sperly/wasdat/wasdat/wasdat.step

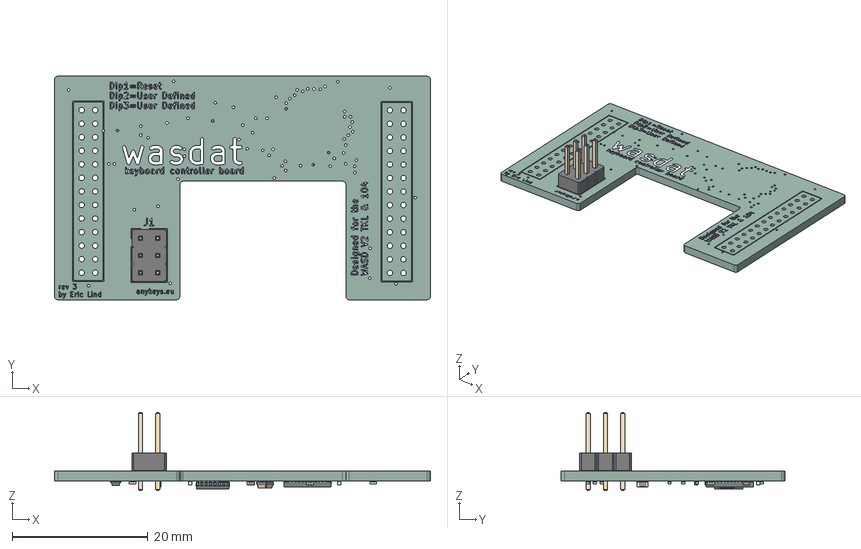
[picture p1: CAD file, 2026-08-13]
wasdat/wasdat.step
55.5 x 33.0 x 11.5 mm
PinHeader_2x03_P254mm_Vertical
C_0402_1005Metric x 7
R_0402_1005Metric x 9
C_0603_1608Metric
TSSOP-16_4.4x5mm_P0.65mm
QFN-44-1EP_7x7mm_Pitch0.5mm
Crystal_SMD_2016-4Pin_2.0x1.6mm
SOT_666
wasdat-unsaved-export-wxZfDO_silkscreen x 2
wasdat-unsaved-export-wxZfDO_PCB
