sperly/wasdat/wasdat/wasdat.kicad_pcb

## KiCad design wasdat/wasdat.kicad_pcb (2026-08-13)

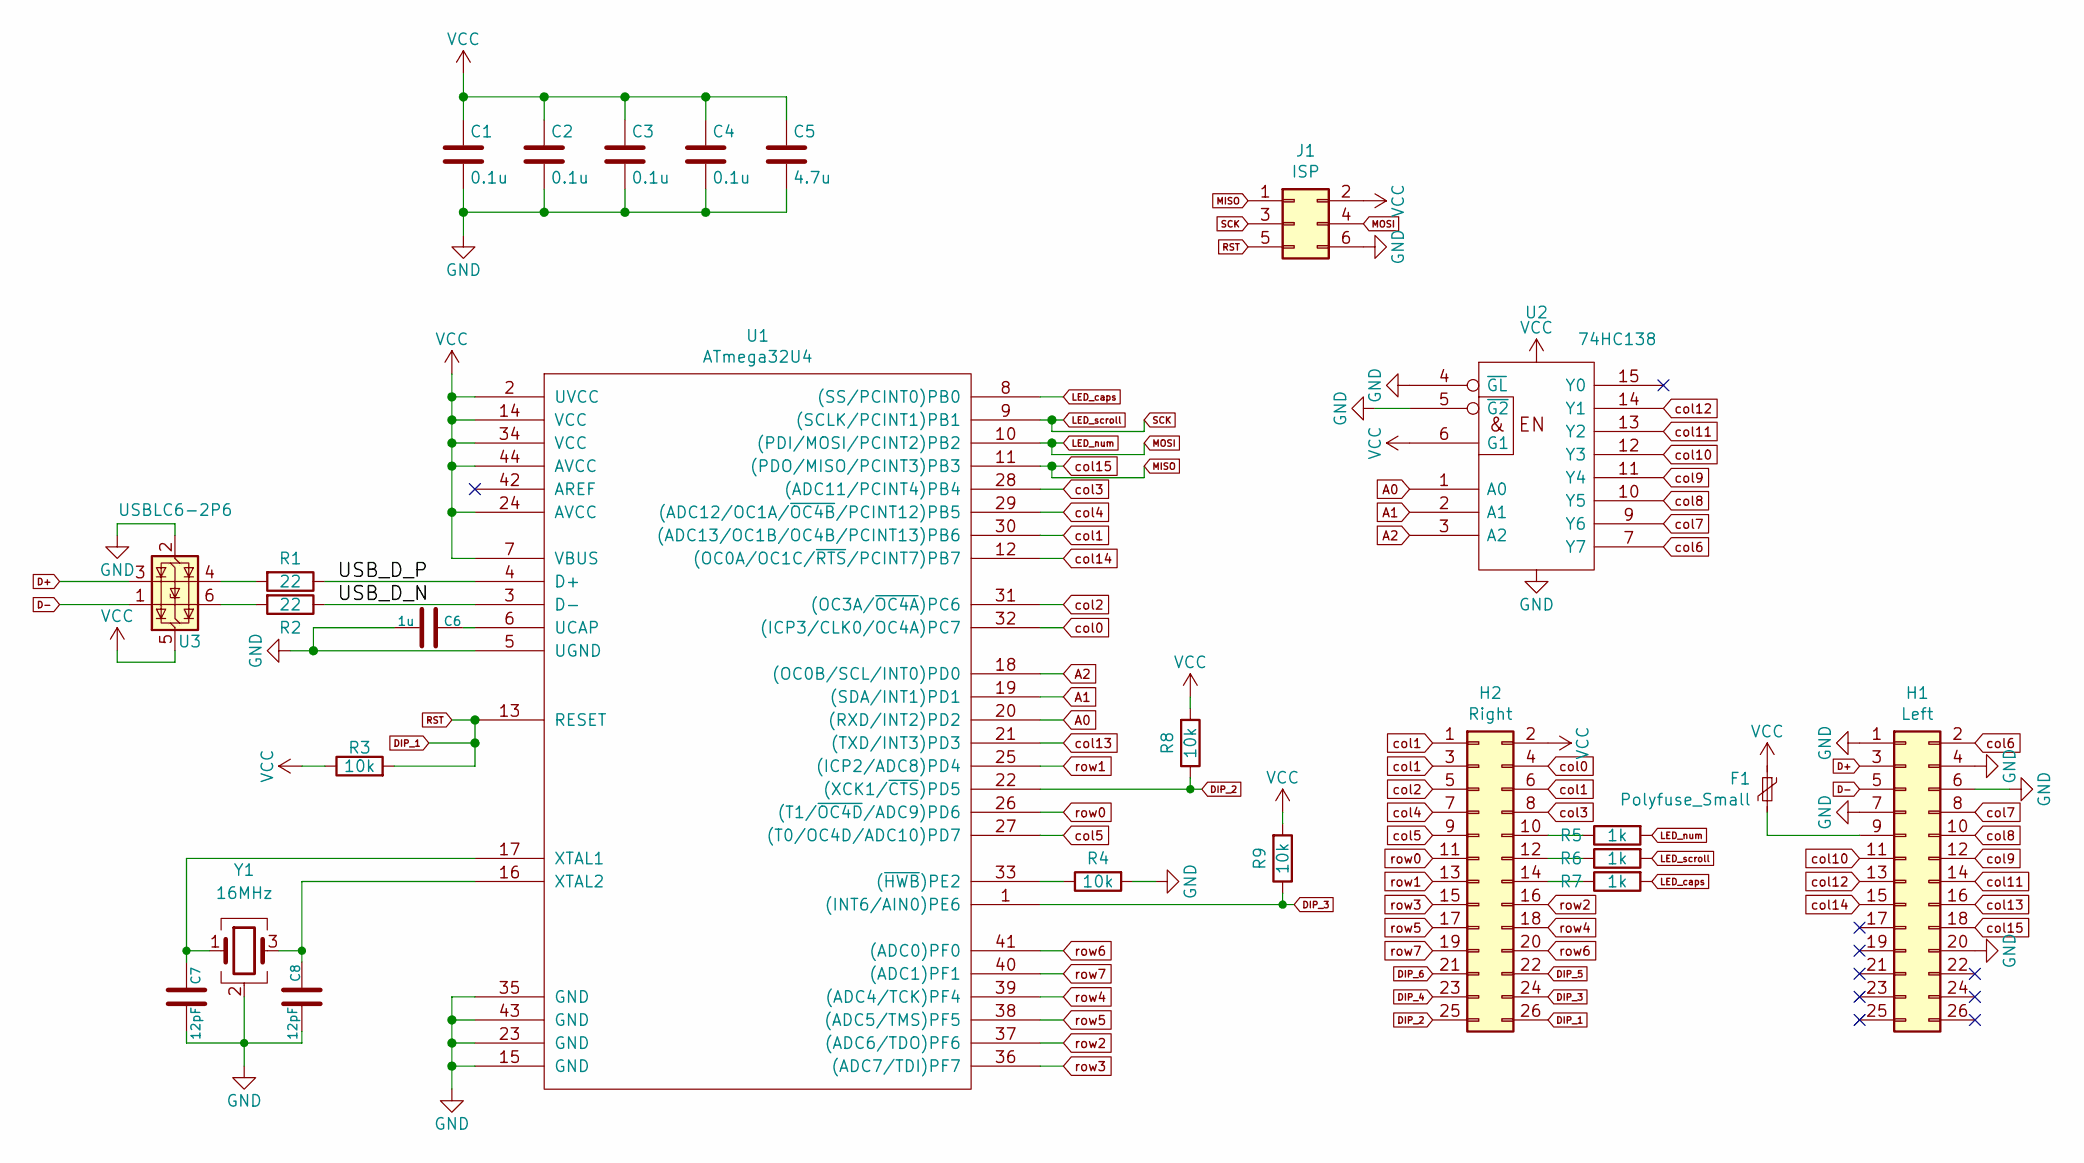
[picture p2: schematic wasdat.kicad_sch]

Parts:
C1, C2, C3, C4: 0.1u; C_0402_1005Metric; LCSC C1525
C5: 4.7u; C_0603_1608Metric; LCSC C19666
C6: 1u; C_0402_1005Metric; LCSC C52923
C7, C8: 12pF; C_0402_1005Metric; LCSC C1547
F1: Polyfuse_Small; R_0805; LCSC C22435710
H1: Left; PinHeader_2x13_P2.00mm_Vertical; LCSC C2883299
H2: Right; PinHeader_2x13_P2.00mm_Vertical; LCSC C2883299
J1: ISP; PinHeader_2x03_P2.54mm_Vertical
R1, R2: 22; R_0402_1005Metric; LCSC C25092
R3, R4, R8, R9: 10k; R_0402_1005Metric; LCSC C60489
R5, R6, R7: 1k; R_0402_1005Metric; LCSC C11702
U1: ATmega32U4; QFN-44-1EP_7x7mm_P0.5mm_EP5.15x5.15mm; LCSC C112161
U2: 74HC138; TSSOP-16_4.4x5mm_P0.65mm; LCSC C157527
U3: USBLC6-2P6; SOT-666; LCSC C15999
Y1: 16MHz; Crystal_SMD_2016-4Pin_2.0x1.6mm; LCSC C254260

Connections:
/USB_D_N: R2.1, U1.3 (D-)
/USB_D_P: R1.1, U1.4 (D+)
A0: U1.20 ((RXD/INT2)PD2), U2.1 (A0)
A1: U1.19 ((SDA/INT1)PD1), U2.2 (A1)
A2: U1.18 ((OC0B/SCL/INT0)PD0), U2.3 (A2)
D+: H1.3, U3.3 (I/O2)
D-: H1.5, U3.1 (I/O1)
DIP_1: H2.26, J1.5, R3.2, U1.13 (RESET)
DIP_2: H2.25, R8.1, U1.22 ((XCK1/~CTS)PD5)
DIP_3: H2.24, R9.1, U1.1 ((INT6/AIN0)PE6)
DIP_4: H2.23
DIP_5: H2.22
DIP_6: H2.21
GND: C1.2, C2.2, C3.2, C4.2, C5.2, C6.2, C7.2, C8.2, H1.1, H1.4, H1.6, H1.7, H1.20, J1.6, R4.2, U1.5 (UGND), U1.15 (GND), U1.23 (GND), U1.35 (GND), U1.43 (GND), U2.4 (~GL), U2.5 (~G2), U2.8 (GND), U3.2 (GND), Y1.2 (G), Y1.4 (G)
LED_caps: R7.2, U1.8 ((SS/PCINT0)PB0)
LED_num: J1.4, R5.2, U1.10 ((PDI/MOSI/PCINT2)PB2)
LED_scroll: J1.3, R6.2, U1.9 ((SCLK/PCINT1)PB1)
MISO: H1.18, J1.1, U1.11 ((PDO/MISO/PCINT3)PB3)
unnamed: F1.2, H1.9
unnamed: H2.10, R5.1
unnamed: H2.12, R6.1
unnamed: H2.14, R7.1
unnamed: R1.2, U3.4 (I/O2)
unnamed: R2.2, U3.6 (I/O1)
unnamed: R4.1, U1.33 ((~HWB)PE2)
unnamed: C6.1, U1.6 (UCAP)
unnamed: C7.1, U1.17 (XTAL1), Y1.1
unnamed: C8.1, U1.16 (XTAL2), Y1.3
VCC: C1.1, C2.1, C3.1, C4.1, C5.1, F1.1, H2.2, J1.2, R3.1, R8.2, R9.2, U1.2 (UVCC), U1.7 (VBUS), U1.14 (VCC), U1.24 (AVCC), U1.34 (VCC), U1.44 (AVCC), U2.6 (G1), U2.16 (VCC), U3.5 (VBUS)
col0: H2.4, U1.32 ((ICP3/CLK0/OC4A)PC7)
col1: H2.1, H2.3, H2.6, U1.30 ((ADC13/OC1B/OC4B/PCINT13)PB6)
col2: H2.5, U1.31 ((OC3A/~OC4A)PC6)
col3: H2.8, U1.28 ((ADC11/PCINT4)PB4)
col4: H2.7, U1.29 ((ADC12/OC1A/~OC4B/PCINT12)PB5)
col5: H2.9, U1.27 ((T0/OC4D/ADC10)PD7)
col6: H1.2, U2.7 (Y7)
col7: H1.8, U2.9 (Y6)
col8: H1.10, U2.10 (Y5)
col9: H1.12, U2.11 (Y4)
col10: H1.11, U2.12 (Y3)
col11: H1.14, U2.13 (Y2)
col12: H1.13, U2.14 (Y1)
col13: H1.16, U1.21 ((TXD/INT3)PD3)
col14: H1.15, U1.12 ((OC0A/OC1C/~RTS/PCINT7)PB7)
row0: H2.11, U1.26 ((T1/~OC4D/ADC9)PD6)
row1: H2.13, U1.25 ((ICP2/ADC8)PD4)
row2: H2.16, U1.37 ((ADC6/TDO)PF6)
row3: H2.15, U1.36 ((ADC7/TDI)PF7)
row4: H2.18, U1.39 ((ADC4/TCK)PF4)
row5: H2.17, U1.38 ((ADC5/TMS)PF5)
row6: H2.20, U1.41 ((ADC0)PF0)
row7: H2.19, U1.40 ((ADC1)PF1)

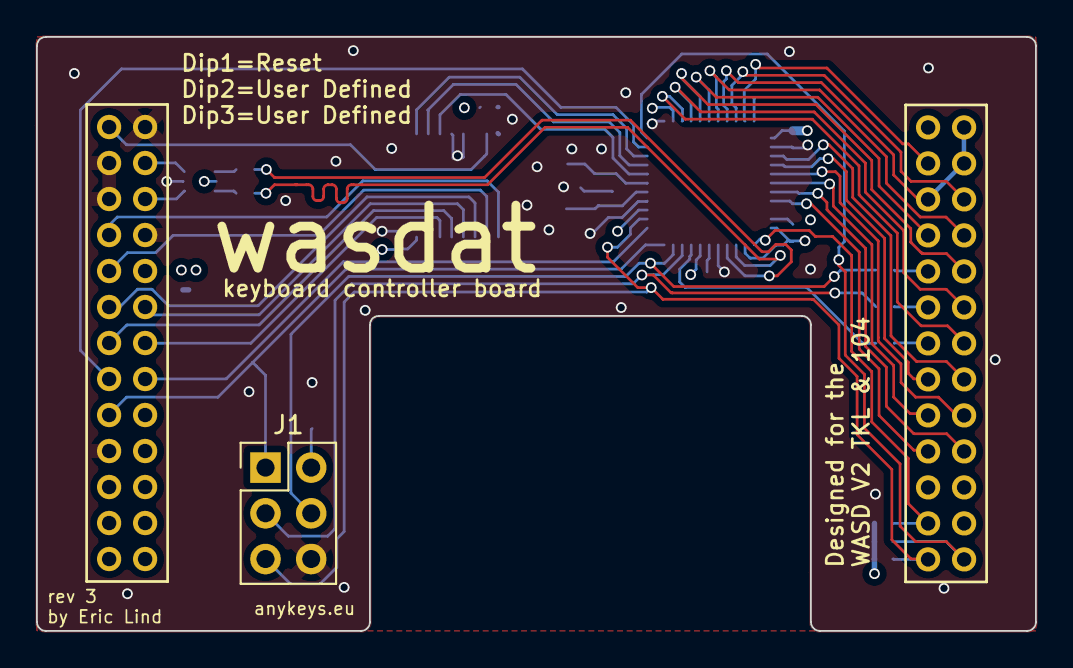
[picture p3: board wasdat.kicad_pcb from above]

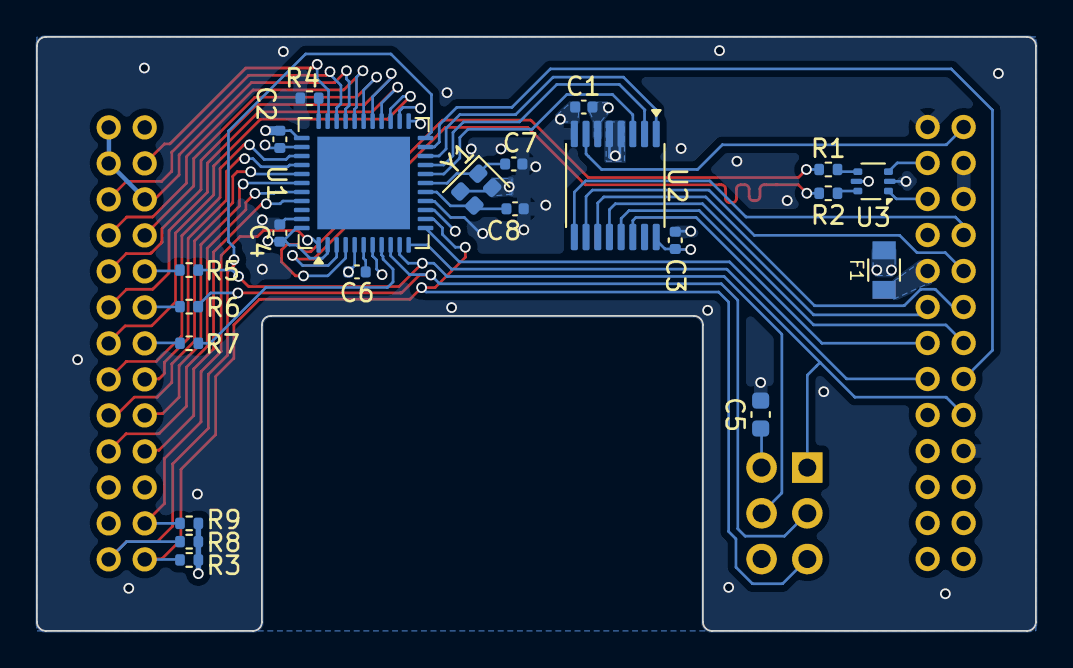
[picture p4: board wasdat.kicad_pcb from below]

Board: 4 copper layers, 55.5 x 33.0 mm, 25 parts (24 on the bottom side), 49 nets.
