sperly/wasdat/(commit log)

2026-08-12 Fixing a cleaner version that is cheaper to produce.
    [BOM-wasdat.csv, wasdat.kicad_pcb, wasdat.kicad_sch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]
2026-08-12 More clean up
    [wasdat.kicad_pcb, wasdat.kicad_sch]
2026-08-13 Final updates, added 2 dip sw for user usage.
    [BOM-wasdat.csv, wasdat.kicad_pcb, wasdat.kicad_sch, wasdat.step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]
